hinamiku415/-2025-C-/04_Docs_Protocols/26年电赛校赛设计文档.docx

# 基于单目视觉的运动目标物测量装置

## 摘要

本系统以树莓派4B为视觉核心、STM32F103VET6单片机为小车控制核心，STM32F103C8T6为测量电路主控。树莓派搭载OpenCV视觉处理框架，采用Picamera2摄像头采集目标板图像，通过OTSU自适应阈值与Canny边缘检测相结合的三路径检测算法实现A4目标板外框检测，使用透视变换将图像矫正到标准坐标系，利用单目焦距公式实现0~200cm范围内非接触测距，同时实现圆形、三角形、正方形的形状识别与边长测量。小车上搭载A4纸大小目标物固定板，通过蓝牙JDY-31无线通信接收树莓派下发的定距指令，采用编码器电机配合位置式串联PID闭环控制实现轴线精准循迹、定距行进与自动停止。测量电路采用INA226高精度电流传感器与5mΩ采样电阻实现系统供电电流Is和功率P的实时监测，对最大功率Pmax进行追踪。测量电路与树莓派之间通过UART串口进行状态切换与数据交互，HMI串口屏负责用户交互与结果显示。实验结果表明，系统可在规定时间内完成全部测量与控制任务，距离测量误差小于2.0cm、尺寸测量误差小于0.3cm，小车行驶距离误差小于0.5cm，电流误差满足竞赛指标要求，系统运行稳定、响应迅速。

关键词： 树莓派4B、STM32F103、单目视觉、PID算法、蓝牙通信、INA226、OpenCV

## 1. 方案论证

### 1.1 方案分析与选择

1.1.1 视觉处理方案选择

方案一：采用K210/Kendryte AI芯片内置卷积加速器进行边缘检测与图像处理。优点是内置硬件加速、功耗低；缺点是算力有限，复杂视觉算法(如多路径框检测、YOLO推理)难以运行，开发灵活性不足。

方案二：采用OpenMV Cam嵌入式视觉模块。优点是开发简便、内置常用视觉算法；缺点是分辨率受限、处理帧率低，透视变换和多帧融合等复杂操作性能不足。

方案三：采用树莓派4B + Picamera2 + OpenCV方案。优点包括：4核ARM Cortex-A72处理器算力充沛，可在1280x720分辨率下实现60fps画面采集与实时处理；OpenCV库提供完整的二值化、形态学操作、轮廓检测等算法支持；支持MJPG Web视频流远程监控调试；可运行ONNX Runtime进行YOLOv5推理实现数字识别；具备蓝牙RFCOMM Socket直接控制小车。缺点是功耗稍高(约5V/2A)。综合考虑竞赛对精度、速度和多模式测量的要求，选择方案三。

1.1.2 小车通信方案选择

方案一：NRF24L01 2.4GHz无线模块通过SPI与STM32通信。优点是低延迟、可配置性强；实测存在SPI通信易受电机振动和电源噪声干扰、芯片频繁进入掉电模式、半双工限制下持续发送接收不稳定等严重问题。

方案二：蓝牙JDY-31模块通过UART与STM32通信。优点是抗干扰能力强、全双工通信、协议简单可靠(文本指令GO/STOP/TARGET)、树莓派内置蓝牙无需额外硬件。缺点是延迟略高于NRF24L01(约20ms)。经过实际测试对比，蓝牙方案稳定性远超NRF24L01，停车精度满足竞赛要求，选择方案二。

1.1.3 测量电路方案选择

方案一：采用ADC直接采样精密电阻两端电压，由STM32内置12位ADC转换计算电流。优点是电路简单、成本低；缺点是分辨率有限(5V/4096=1.22mV/LSB)，小电流下读数噪声大，功率计算精度差。

方案二：采用INA226专用电流/功率监测芯片。优点是集成16位ADC，内置分流电压测量(2.5μV/LSB)、总线电压测量(1.25mV/LSB)、功率计算和校准寄存器；通过I2C接口直接读取工程值，精度高、抗干扰强。选择方案二。

1.1.4 主控芯片选择

测量电路主控选用STM32F103C8T6，小车端主控选用STM32F103VET6。C8T6负责串口屏交互、树莓派通信、OLED显示、按键响应和INA226电流监测；VET6负责电机PWM驱动、编码器PID控制、循迹传感器采集和蓝牙指令接收。

### 1.2 方案描述

系统整体架构采用”一树莓派 + 双STM32”三核心分布式结构，如图1所示。

树莓派4B视觉子系统： 运行Python视觉处理程序(main.py)，负责Picamera2摄像头采集(1280x720@60fps)、A4目标板外框检测(三路径互补算法)、距离测量(焦距公式)、形状识别与尺寸测量(模式2~5)、数字识别(模板匹配/YOLOv5 ONNX)。通过USB转TTL模块(UART，115200bps)与测量电路STM32通信，通过内置蓝牙(JDY-31 RFCOMM)与小车通信。

测量电路STM32F103C8T6： 负责系统主控逻辑。通过HMI串口屏(USART1，9600bps)接收用户模式选择和参数输入(D/N)；通过UART串口(USART3，115200bps)与树莓派交互控制指令和测量数据；通过I2C接口读取INA226电流传感器数据，计算Pmax并刷新HMI显示；通过OLED 12864显示系统状态。按键1(PA8)实现一键启动全自动操作。

小车端STM32F103VET6： 负责运动执行。通过UART4(9600bps)接收蓝牙GO/STOP指令；TIM1 10ms中断驱动位置式串联PID(位置环+速度环+转向环)控制双电机；编码器(MG513X，1456线四倍频)反馈里程；八路灰度循迹模块通过权重法(-7~+7)实现轴线循迹。

完整工作流程： 用户在HMI屏选择竞赛题目对应状态并输入参数，按下物理按键一键启动 → STM32通过串口发送MODE指令给树莓派 → 树莓派切入实时测距模式，通过蓝牙发送GO启动小车 → 树莓派60fps持续测距并通过串口发送D值给STM32显示 → 当距离达到目标值+提前量(15cm)时发送蓝牙STOP → 小车反向制动停车 → 树莓派检测停稳后自动切到目标测量模式拍照测量 → 结果通过串口回传STM32 → HMI屏和OLED显示测量结果，同时显示电流和功耗数据。

## 2. 理论分析与计算

### 2.1 单目视觉测量分析

2.1.1 测距原理

本系统采用基于已知目标物尺寸的单目测距方法。摄像头固定在支架上，对前方A4标准目标板（黑框白底，外框21.0cm×29.7cm）进行拍摄。根据小孔成像模型，目标物在图像中的像素高度h_px与实际距离D满足反比关系：

D=(F×H)/(h_(px))

其中F为相机焦距像素值，H为A4纸高度29.7cm。焦距F通过标定获得：将目标板放置在已知距离D_cal处，测量其在图像中的像素高度h_cal，计算F = D_cal × h_cal / H。本系统标定焦距F=1697.80。

为提高测量稳定性，取A4纸左右两侧高度像素的最大值作为h_px，并通过15帧中值滤波消除瞬时噪声。

2.1.2 外框检测算法

系统采用三条互补检测路径实现不同光照条件下的鲁棒框检测：

- 路径A（OTSU二值化）： 对高斯模糊后的灰度图进行OTSU自适应阈值二值化，使用15/30/50/80四种核大小的形态学闭运算连接白色区域，提取轮廓并通过approxPolyDP四边形逼近和宽高比验证筛选候选。
- 路径B（自适应阈值）： 采用高斯自适应阈值(blockSize=51, C=10)处理非均匀光照场景(阴影、亮斑)，形态学处理后检测轮廓。
- 路径C（Canny边缘检测）： 对低对比度场景使用Canny边缘检测(阈值30/120)提取边缘轮廓，不依赖二值化结果。

三条路径的所有候选合并去重(中心距<30px)，最终选取面积最大的四边形作为A4目标板外框。

2.1.3 透视变换与尺寸测量

检测到目标板四角点后，通过透视变换将目标板映射到630×891像素的标准矩形坐标系(PX_PER_CM=30)。在矫正后的正视图上进行图形检测和尺寸测量，边长x_cm = 边长像素 / px_per_cm，其中px_per_cm取水平和垂直缩放系数的平均值。

2.1.4 图形识别原理

模式2（形状识别）： 对矫正图像进行OTSU反向二值化提取黑色图形，排除黑框区域后检测轮廓。通过approxPolyDP顶点数判断形状(3个顶点=三角形，4个顶点=正方形，>8个顶点=圆形)。正方形通过边长比(max/min≤1.20)和内角偏差(≤22°)验证。

模式3（多正方形最小边长）： 检测所有黑色正方形，通过相邻直角点对法和轮廓兜底法双重检测，IoU去重后输出最小边长。

模式4/5（带编号正方形+倾斜矫正）： 对每个检测到的正方形内区域，通过模板匹配或YOLOv5 ONNX推理识别数字编号。模式5下TiltCorrector类估算倾斜角度(利用对边比arccos)并施加二次透视变换补偿前缩效应。

### 2.2 小车行驶分析

在本任务中，小车行驶核心任务是完成轴线循迹、定距行进、精准停驻，满足竞赛对行驶偏差、距离误差、自动控制的硬性要求，全程由测量电路通过蓝牙无线通信下发指令，无人工干预与遥控操作。

2.2.1 小车控制分析

本系统小车采用TB6612电机驱动、MG513X编码器直流电机，通过定时器通道输出PWM信号控制小车行进速度，以循迹模组获取轴线偏差数据，编码器实时反馈行驶里程，通过蓝牙JDY-31无线模块接收行进距离，由位置式串联PID闭环算法：

u(k)=K_p e(k)+K_i ∑_(j=0)^k e(j)+K_d [e(k)-e(k-1)]

控制电机转速、转向与位置。系统采用三层串联PID结构： - 位置环（外环）： 以目标距离TotalError为输入，编码器累计距离Actual_Location为反馈，输出目标速度给速度环 - 速度环（内环）： 以位置环输出为设定速度，10ms编码器增量/周期为实际速度反馈，输出PWM占空比 - 转向环（差速控制）： 以循迹模块输出的轴线偏差值(-16~+16)为输入，对左右电机施加差速分量

2.2.2 轴线循迹分析

本系统小车轴线循迹采用八路灰度循迹模块，循迹模块通过串行输出，将灰度传感值返回数字量并在程序上移位获取八位二进制数。为使小车能够精准沿着轴线行进，使用权重法，将循迹二进制数各个位数赋予权重[-7, -5, -3, -1, 1, 3, 5, 7]并相加转化为十进制数作为转向环PID的输入，由此得出循迹的输入量范围为-16~16。通过配置PWM通道的计数周期和预分频值确定目标范围在-7200~7200，通过计算峰值处于输入范围7200/32，确定比例项的范围在225左右，通过Vofa串口波形图显示软件，结合经验参数以此确定比例、积分、微分的参数数值。

2.2.3 定距行进与停驻控制分析

本系统小车采用位置式串联PID，通过位置环作为外环、速度环作为内环、转向环作为差速控制来控制整个小车的运动控制。轮子采用橡胶轮直径为65mm，电机采用MG513X，减速比为1:28，13线，一圈脉冲为13×28=364，四倍频脉冲为1456，圆周率取3.14，由此得出小车每脉冲行进距离公式为：

S_单脉冲 = 轮子周长/四倍频脉冲数 = 6.5cm × 3.14 / 1456 = 0.014017 cm

通过获取编码器数值，得出小车实际行进总距离公式为：

S_总 = (左轮脉冲数 + 右轮脉冲数) / 2 × S_单脉冲

以S_总作为位置环PID的输入，此外每10ms获取一次编码器的累计值相加求平均作为速度环的实际速度，以位置环的输出作为速度环的输入，实现高抗干扰和高精确度。

2.2.4 蓝牙停车策略

树莓派以60fps频率持续测距，当实时稳定距离stable_d ≤ 目标距离target_d + 提前量(15cm)时，通过蓝牙发送STOP指令给小车。小车收到STOP后执行反向制动(PWM=-800, 持续200ms)后PWM置零停车。树莓派继续测距，连续5帧距离变化<0.5cm确认停稳后，切换到目标测量模式执行视觉测量。这一策略补偿了蓝牙指令传输延迟(~20ms)和刹车惯性距离，确保实际停车位置与目标距离的偏差在容许范围内。

### 2.3 测量电路分析

2.3.1 电流/功率检测原理

采用INA226AQDGSRQ1专用电流/功率监测芯片，配合R8采样电阻（标称5mΩ）实现供电电流和功率的实时测量。

配置参数： - 校准值计算：Calib = 0.00512 / (Current_LSB × R_shunt)，其中Current_LSB = I_MAX / 32768 - 最大测量电流I_MAX设置为1.1A，R_shunt标称值为0.005Ω，Calib计算值约3052 - 转换配置：平均16次采样，转换时间1.1ms，连续测量分流电压和总线电压

两条电流计算路径： - 路径A（芯片内部计算）： I = 电流寄存器值 × Current_LSB，依赖校准寄存器写入正确 - 路径B（Raw软件计算）： I = 分流电压(μV) / R_shunt(Ω) / 1000 × RAW_CORRECTION，不依赖校准值

实测采样电阻实际阻值约2.4mΩ（与标称值有偏差，PCB并联路径导致），通过RAW_CORRECTION=2.08补偿Raw路径，通过调整I_MAX使I路径读数校正。

功率计算： - P_实时(mW) = 总线电压寄存器值 × 1.25mV/LSB × I(mA) - P_max = max(P_实时) ——在每次采样时追踪最大值

2.3.2 系统功耗分析

系统供电电压标称5V，树莓派4B满负荷功耗约5V/2A=10W，STM32+外围设备功耗约5V/0.2A=1W，驱动板+电机功耗随负载变化约5V/0.5~2A。系统总峰值功耗约10W+1W+10W≈21W。测量电路通过INA226以约200ms周期持续采样电流和功率，向HMI屏发送t_Is(电流mA)、t_P(功率mW)、t_Pm(最大功率mW)显示。

### 2.4 误差分析

2.4.1 单目视觉误差分析

1. 焦距标定误差： 焦距标定时人工测量距离存在±0.5cm测量误差，经传播后对测量结果的影响为δD = (D / D_cal) × δD_cal，当标定距离80cm时，80cm处误差约±0.5cm，200cm处误差约±1.25cm
2. 像素量化误差： 摄像头分辨率为1280×720，在200cm处A4纸高度约85像素，每像素对应约200×29.7/85×85×85/1697.8≈2.3cm/像素的测距分辨率，通过中值滤波和多帧均值有效降低
3. 外框检测漂移： 光照变化或遮挡导致角点定位偏差，通过8帧滑动窗口平滑(连续50帧丢失则使用最后有效值)保证稳定性
4. 透视变换累积误差： 角点偏差通过透视变换传递到尺寸测量，多帧(5帧)中位数聚合策略抑制单帧异常
5. 倾斜测量误差(模式5)： TiltCorrector利用对边比arccos估算倾斜角，理想条件下cos(30°)=0.866，cos(60°)=0.5，角度估计误差容差为5°

2.4.2 小车行进误差分析

1. PID参数导致的过冲振荡导致偏离指定位置：位置环Kp过大引起编码器目标距离处的过冲，Kd可抑制振荡但过大引入噪声
2. 电机参数与商家标定有出入：实测MG513X电机减速比和脉冲数与标称值存在微小偏差，导致编码器计算距离与实际距离略有差距，需通过实测标定修正S_单脉冲值
3. 轮胎打滑：橡胶轮与地面摩擦力不足时编码器计数而轮胎未实际滚动，尤其在急加速/减速时显著
4. 循迹偏差：八路灰度模块在光照变化或地板颜色不均时可能误判轴线位置，导致小车偏离预设轨迹

2.4.3 测量电路误差分析

1. 采样电阻精度： R8标称5mΩ±1%，实际阻值因PCB并联路径降至约2.4mΩ，通过RAW_CORRECTION=2.08校正后残余误差约±3mA
2. INA226 ADC精度： 分流电压分辨率2.5μV/LSB，对应R=5mΩ时电流分辨率0.5mA/LSB，16次平均后噪声降低至±1mA
3. 总线电压测量误差： 分辨率1.25mV/LSB，5V满量程误差约0.025%，工程上可忽略
4. 温度漂移： 采样电阻温漂系数约±50ppm/°C，工作温度变化20°C引入约0.1%误差，对竞赛场景影响微小

## 3. 电路与程序设计

### 3.1 单目视觉设计

3.1.1 软件架构

树莓派视觉系统采用Python编写，核心文件及功能如下：

文件 | 功能
main.py | 主程序入口：摄像头采集、Flask Web服务(可选)、后台帧处理线程、串口监听、蓝牙小车控制逻辑
config.py | 全局参数：串口/蓝牙/相机配置、物理尺寸、检测阈值、数字识别方式
modes.py | 测量核心：模式1~5实现，含透视变换、正方形检测、形状分类、倾斜矫正、多帧融合
utils.py | 视觉工具：三路径外框检测、测距公式(焦距模型)、焦距标定、距离缓冲区
serial_comm.py | 串口通信：与STM32的UART通信，支持二进制帧和文本行协议
bt_comm.py | 蓝牙通信：JDY-31 RFCOMM Socket，GO/STOP/TARGET指令，断线自动重连
templates.py | 模板匹配数字识别：多变体模板加载、比值测试+绝对距离双重判别
yolo_num.py | YOLOv5 ONNX数字识别（可选）：ONNX Runtime推理、3检测头anchor解码、NMS后处理

3.1.2 视觉处理流水线

1. 帧采集： Picamera2 1280×720 RGB @ 60fps
2. 外框检测(utils.py detece_a4_outer)： 三路径互补 → 候选合并去重 → 选最大面积
3. 时间平滑(main.py get_stable_outer)： 8帧滑动窗口角点均值
4. 模式路由(mode 0~5)：
  - 模式1：实时测距+中值滤波，持续输出D值
  - 模式2：透视变换+轮廓形状辨识
  - 模式3：正方形检测+最小边长
  - 模式4：正方形+模板匹配/YOLO数字编号
  - 模式5：倾斜角估计+二次透视矫正+编号方形
5. 多帧融合： 拍5帧(间隔50ms)，距离和边长取中位数，模式4/5按编号聚合
6. 结果输出： 通过串口发送D:值,shape:类型,x:尺寸或D:值,N:编号,x:尺寸给STM32

3.1.3 关键算法参数

参数 | 值 | 说明
焦距 | 1697.80 px | 标定值
A4黑框尺寸 | 21.0×29.7 cm | W×H，实测值
透视变换像素 | 30 px/cm | PX_PER_CM
框检测最小面积 | 画面2% | 排除噪点
宽高比容差 | ±20% | 排除正方形等干扰
平滑窗口 | 8帧 | 时间稳定性
正方形验证 | 边长比≤1.20, 角度偏差≤22° | 质量控制
多帧数 | 5帧, 间隔50ms | 抗波动
模板对比值阈值 | 0.75 | 最佳/次佳比
倾斜角范围 | 30°~60° | 模式5

### 3.2 小车程序设计

设计思路为：系统小车开启后，设定小车标志位和状态机，当测量电路蓝牙无线通信模块JDY-31发送启动指令GO后，行进标志Car_state2置1，此时启动小车以PID目标速度7匀速前进并开启循迹。当到达指定距离后，树莓派通过视觉测距判断距离达标，蓝牙发送STOP指令，小车收到后反向制动200ms后停车，PWM通道置0，蜂鸣器发出声光提示1秒。

小车状态机： - Car_state2=0：静止(idle) - Car_state2=1：蓝牙收到GO后启动，匀速前进+循迹 - Car_state2=2：到达目标，蜂鸣响1秒后自动切回0

定时中断(TIM1 10ms)： - Key_Tick()：按键消抖 - Control_kick()：到达检测(Car_state模式) - Encoder_Read()：编码器脉冲读取累加 - Read_Track_DATA()：八路灰度采集 - Track_Control()：循迹转向控制 - Target_Location_arrive_D()：蓝牙模式下PID速度控制(target=7) - Target_Location_arrive()：基础1编码器PID位置控制

### 3.3 测量电路设计

3.3.1 STM32F103C8T6主控设计

测量电路以STM32F103C8T6为控制核心，主要功能模块：

串口及通信： - USART1(PA9/PA10, 9600bps)：连接淘晶驰TJC HMI串口屏，单向接收状态切换字节(0x00~0x14)，接收文本参数指令(D=xxx/N=x)，向HMI发送Nextion格式显示更新 - USART3(PB10/PB11, 115200bps)：连接树莓派USB转TTL模块，发送MODE:x/TRIGGER/D=xxx/N=x等控制指令，接收D:xxx/形状/尺寸测量结果

I2C外设(PB6/PB7，软件I2C)： - INA226(地址0x40)：电流/电压/功率传感器，200ms周期采样 - OLED 12864(地址0x78)：4行×16字符状态信息显示

GPIO： - PA8：物理按键1(一键启动)，上拉输入，低电平触发

系统状态机(7个状态)： - STATE_IDLE(0)：空闲 - STATE_BASIC_1(1)：基础1-小车循迹1米 - STATE_BASIC_2(2)：基础2-静止测量 - STATE_BASIC_34(3)：基础3/4-前进到D停止测量 - STATE_ADV_1(4)：发挥1-静止测最小正方形 - STATE_ADV_2(5)：发挥2-前进测最小正方形 - STATE_ADV_3(6)：发挥3-前进测指定编号正方形 - STATE_ADV_45(7)：发挥4/5-倾斜板前进测量

一键启动逻辑： 用户通过HMI屏选择状态并输入参数后，按物理按键一键启动。App_HandleKey()根据当前状态发送对应的MODE、D、N指令给树莓派，树莓派根据指令自动完成小车启动、停车监控、视觉测量、结果回传整个流程，无需二次人工干预。

HMI通信协议： - HMI→STM32： - 状态切换：单字节(0x00=IDLE, 0x01~0x14=各状态) - 参数指令：文本行(D=xxx\n, N=x\n)，Command_Parser()解析 - STM32→HMI： - 控件更新：obj.txt=“value” + 0xFF 0xFF 0xFF(Nextion格式) - 主要控件：D(距离cm)、X(边长cm)、N(编号列表)、t_Is(电流mA)、t_P(功率mW)、t_Pm(最大功率mW)

树莓派通信协议(文本行，\n结尾)： - STM32→树莓派：MODE:2/3/4/5、TRIGGER、D=150、N=2 - 树莓派→STM32：D:120.50、D:120.50,shape:square,x:8.30、D:80.42,N:4,x:9.67、STATUS:mode=3,status=2、ERROR:xxx

## 4. 测试方案与测试结果

### 4.1 测试方案

4.1.1 测试环境与仪器

- 测量距离：卷尺(精度1mm)，用于验证视觉测距结果
- 尺寸测量：游标卡尺(精度0.02mm)，用于验证图形边长测量结果
- 电流监测：数控直流稳压电源(带电流显示，精度1mA)，用于验证INA226电流读数
- 小车距离：地面标记+卷尺，用于验证小车行驶距离精度
- 测试场景：室内均匀光照环境，目标板垂直放置于平整地面

4.1.2 测试项目

基础部分测试： 1. 基础1：小车循迹1米行驶距离测试——测量小车实际行驶距离与目标距离(100cm)的偏差 2. 基础2：静止测量测试——目标板固定在不同距离(80~200cm)处，测量距离D的准确性及形状识别的正确率 3. 基础3：前进到D1距离停止后测量——验证小车自动停止位置的精度及随后的视觉测量准确度 4. 基础4：前进到D2距离停止后测量——测试不同目标距离下的全自动流程

发挥部分测试： 5. 发挥1：静止状态下检测多个正方形的最小边长——验证重叠正方形检测和最小边长识别能力 6. 发挥2：前进到D3距离停止后检测最小正方形——验证运动+测量全流程 7. 发挥3：前进到D4距离停止后检测指定编号正方形的边长——验证编号识别准确率 8. 发挥4/5：目标板倾斜30°~60°时识别指定编号正方形——验证倾斜矫正算法的准确性 9. 发挥6：系统供电电流Is和功率P/Pmax实时监测——验证INA226电流监测精度

4.1.3 测试方法

通过测量电路的蓝牙无线通信模块向小车发送指定距离行进指令，小车自动前进并停驻。树莓派执行单目视觉测量获得边长与距离数据。同时测量电路监测电流和功率大小。将各项测量数据与真值对比，验证是否满足竞赛任务要求。

### 4.2 测试结果

4.2.1 基础部分

距离测量精度测试：

实际距离 (cm) | 测量距离 (cm) | 误差 (cm) | 误差率
80 | 79.8 | -0.2 | 0.25%
100 | 100.5 | +0.5 | 0.50%
120 | 119.7 | -0.3 | 0.25%
150 | 150.8 | +0.8 | 0.53%
180 | 178.5 | -1.5 | 0.83%
200 | 201.2 | +1.2 | 0.60%

最大误差1.5cm，满足竞赛≤2.0cm的指标要求。

形状尺寸测量精度测试(距离120cm处)：

图形类型 | 实际尺寸 (cm) | 测量尺寸 (cm) | 误差 (cm)
圆形(直径) | 8.0 | 8.15 | +0.15
三角形(边长) | 8.0 | 7.92 | -0.08
正方形(边长) | 8.0 | 7.85 | -0.15

最大误差0.15cm，满足竞赛≤0.3cm的指标要求。

小车行驶距离测试(目标100cm)：

测试次数 | 实际行驶距离 (cm) | 误差 (cm)
1 | 100.3 | +0.3
2 | 99.5 | -0.5
3 | 100.1 | +0.1

最大误差0.5cm，满足竞赛≤0.5cm的指标要求。

小车自动停车精度测试(蓝牙方案，目标150cm)：

测试次数 | 实际停车距离 (cm) | 误差 (cm)
1 | 149.5 | -0.5
2 | 150.3 | +0.3
3 | 148.8 | -1.2

最大误差1.2cm，在竞赛容许范围内。

形状识别正确率：

图形类型 | 测试次数 | 正确次数 | 正确率
圆形 | 20 | 20 | 100%
三角形 | 20 | 20 | 100%
正方形 | 20 | 20 | 100%

4.2.2 发挥部分

多正方形最小边长(x)检测测试：

正方形数量 | 最小边长真值 (cm) | 测量最小边长 (cm) | 误差 (cm)
3个(含重叠) | 4.0 | 4.12 | +0.12
3个(含重叠) | 5.0 | 4.88 | -0.12

编号识别准确率测试：

编号 | 测试次数 | 正确次数 | 正确率
1 | 20 | 20 | 100%
2 | 20 | 20 | 100%
3 | 20 | 19 | 95%
5 | 20 | 20 | 100%
8 | 20 | 18 | 90%

模板匹配总体正确率约97%。编号8误识别主要源于与数字0的形似。

倾斜矫正(模式5)指定编号正方形边长测量：

倾斜角 | 编号 | 实际边长 (cm) | 测量边长 (cm) | 误差 (cm)
30° | 2 | 8.0 | 7.82 | -0.18
45° | 2 | 8.0 | 8.22 | +0.22
60° | 4 | 6.0 | 5.76 | -0.24

最大误差0.24cm，满足竞赛≤0.3cm的指标要求。

电流监测精度测试(INA226 vs 数控电源)：

数控电源电流 (mA) | INA226 I路径 (mA) | INA226 Raw路径 (mA) | 误差 (mA)
200 | 199 | 201 | ±2
500 | 498 | 503 | -2/+3
800 | 805 | 802 | +5/+2
1100 | 1108 | 1102 | +8/+2

基于实际采样电阻2.4mΩ与标称值5mΩ的偏差，I路径经MAX_CURRENT_A校正、Raw路径经RAW_CORRECTION=2.08校正后，全范围误差<±10mA，满足竞赛指标。

全流程耗时测试：

流程阶段 | 耗时
HMI选择+按键触发 | <1s
小车从静止到150cm处停稳 | ~4s
停稳检测(5帧确认) | ~0.3s
视觉测量(5帧多帧融合) | ~0.3s
结果发送+HMI显示 | <0.1s
总计 | <6s

满足竞赛10秒内完成全流程操作的要求。

## 5. 总结

本系统通过理论分析得到合理的方案，采用树莓派 + 双STM32三核心架构，实现单目视觉距离和尺寸测量、小车精准循迹定距、自制电流功耗监测三大任务功能。

在视觉测量方面，基于单目焦距模型和三路径互补外框检测算法，实现了0200cm范围内稳定的距离测量(误差<2.0cm)和图形尺寸测量(误差<0.3cm)；通过透视变换+多帧融合策略有效抑制了帧间波动；倾斜矫正器(TiltCorrector)在30°60°倾斜条件下保持了尺寸测量精度。

在小车控制方面，蓝牙JDY-31替代了稳定性不佳的NRF24L01无线模块，配合树莓派60fps实时测距停车监控，实现了精准的自动停车控制；位置式串联PID(位置环+速度环+转向环)结合权重法循迹，保证了轴线行驶精度(偏差<0.5cm)和定距误差(<0.5cm)。

在测量电路方面，INA226高精度电流传感器实现了系统供电电流Is的实时监测和对最大功率Pmax的追踪，两条电流计算路径(芯片I路径和软件Raw路径)互为验证和备份，通过校正系数补偿了采样电阻的阻值偏差。

系统经过全面测试，测量精度、行驶精度、电流误差均满足竞赛指标，6秒内完成全流程操作，运行稳定，各项指标符合”基于单目视觉的运动目标物测量装置”任务要求。
