hinamiku415/-2025-C-/02_Console_STM32/TJC_HMI_Lib/流程图.md

# TJC_HMI_Lib 分层架构流程图

## 架构总览

```mermaid
flowchart TB
    subgraph APP["应用层 (你的代码)"]
        A["用户代码"]
    end

    subgraph CORE["中间层 tjc_hmi.c"]
        direction LR
        C_SEND["SetText() SetNumber() Page()"]
        C_RECV["RxByte() 解析帧 事件回调"]
    end

    subgraph PORT["底层 tjc_hmi_port.c"]
        direction LR
        P_SEND["SendByte() SendBuffer()"]
        P_RECV["USART1_IRQHandler()"]
    end

    subgraph SCREEN["串口屏"]
        direction LR
        S_DISP["显示控件"]
        S_BTN["按钮/输入框"]
    end

    %% 发送流程 - 左侧蓝色
    A -->|"发送指令"| C_SEND
    C_SEND -->|"调用"| P_SEND
    P_SEND -->|"TX 引脚"| S_DISP

    %% 接收流程 - 右侧橙色
    S_BTN -->|"RX 引脚"| P_RECV
    P_RECV -->|"调用"| C_RECV
    C_RECV -->|"事件回调"| A

    %% 样式
    linkStyle 0,1,2 stroke:#1976d2,stroke-width:3px
    linkStyle 3,4,5 stroke:#e65100,stroke-width:3px
```

## 发送流程

```mermaid
sequenceDiagram
    participant App as 应用层
    participant Core as 中间层
    participant Port as 底层
    participant Screen as 串口屏

    App->>Core: TJC_HMI_SetText("D", "120.5cm")
    Core->>Core: 拼接指令 "D.txt=\"120.5cm\""
    Core->>Port: TJC_Port_SendByte('D')
    Core->>Port: TJC_Port_SendByte('.')
    Core->>Port: TJC_Port_SendByte('t')
    Core->>Port: ...
    Core->>Port: TJC_Port_SendByte(0xFF)
    Core->>Port: TJC_Port_SendByte(0xFF)
    Core->>Port: TJC_Port_SendByte(0xFF)
    Port->>Screen: USART_SendData() → TX 引脚
    Screen->>Screen: 显示 "120.5cm"
```

## 接收流程

```mermaid
sequenceDiagram
    participant Screen as 串口屏
    participant Port as 底层
    participant Core as 中间层
    participant App as 应用层

    Screen->>Port: 按钮按下 → RX 引脚
    Port->>Port: USART1_IRQHandler()
    Port->>Port: 读取字节 0xA5
    Port->>Core: TJC_HMI_RxByte(0xA5)
    Core->>Core: 状态机：收到帧头
    Port->>Core: TJC_HMI_RxByte(0x01)
    Core->>Core: 状态机：存入 ID
    Port->>Core: TJC_HMI_RxByte(0x31)
    Core->>Core: 状态机：存入数据
    Port->>Core: TJC_HMI_RxByte(0x5A)
    Core->>Core: 状态机：收到帧尾，解析
    Core->>App: 回调：TJC_EVENT_DATA, id=1, value=1
    App->>App: 判断 ID：1 = 距离
    App->>App: target_D = 1
```

## 两个回调函数

```mermaid
flowchart TD
    subgraph L1["底层"]
        P1["USART1_IRQHandler()"]
    end

    subgraph L2["中间层"]
        C1["TJC_HMI_RxByte()"]
        C2["解析 A5...5A"]
        C3["生成事件"]
    end

    subgraph L3["应用层"]
        A1["HMI_EventHandler()"]
        A2["判断 ID"]
        A3["处理业务"]
    end

    P1 -->|"回调1: 喂字节"| C1
    C1 --> C2
    C2 --> C3
    C3 -->|"回调2: 事件通知"| A1
    A1 --> A2
    A2 --> A3

    style L1 fill:#e8f5e8,stroke:#1b5e20
    style L2 fill:#fff3e0,stroke:#e65100
    style L3 fill:#e1f5fe,stroke:#01579b
```

## 分层职责

| 层 | 文件 | 职责 |
|----|---|---|
| 应用层 | 你的代码 | 定义 ID 含义、处理业务逻辑 |
| 中间层 | tjc_hmi.c | 协议解析、生成事件、控件操作 |
| 底层 | tjc_hmi_port.c | 串口初始化、收发字节、硬件操作 |

## 两个回调函数

| 回调 | 方向 | 作用 |
|---|---|---|
| `TJC_HMI_RxByte()` | 底层 → 中间层 | 喂入接收到的字节 |
| `TJC_HMI_Callback_t` | 中间层 → 应用层 | 通知事件（按钮/数据） |
