hinamiku415/-2025-C-/01_Vision_RaspberryPi/tests/test.jpg

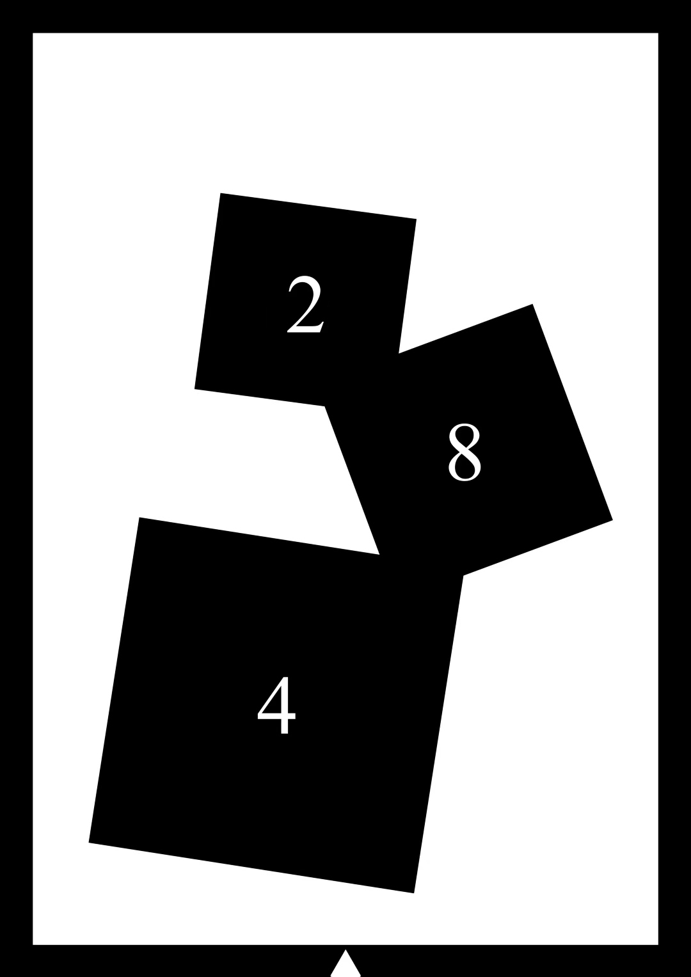
01_Vision_RaspberryPi/tests/test.jpg
