hinamiku415/-2025-C-/assets/demo_result.jpg

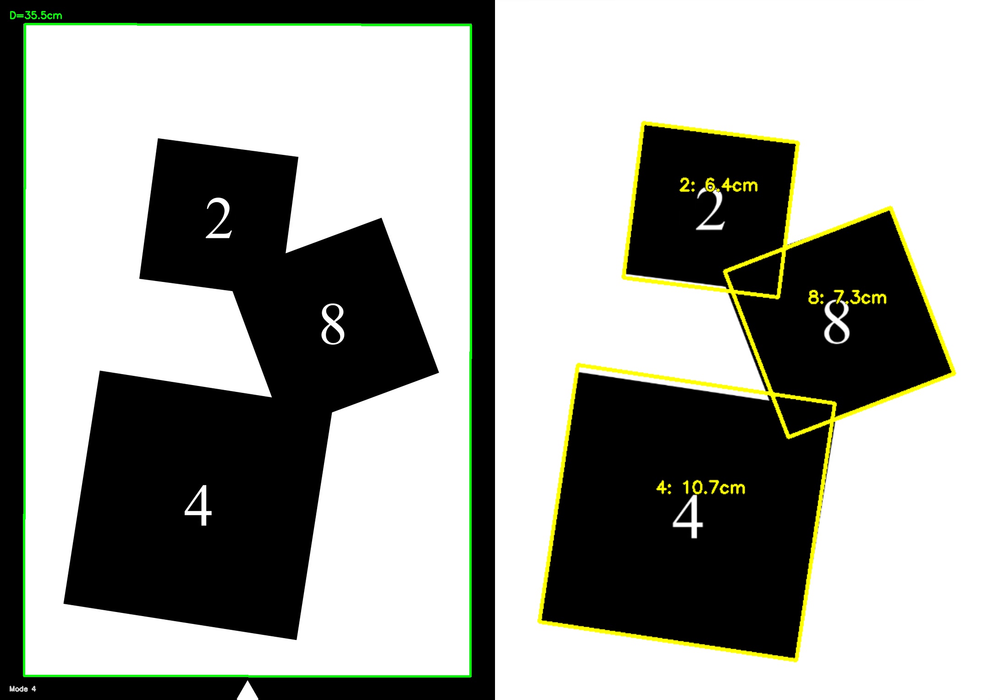
assets/demo_result.jpg
