hinamiku415/-2025-C-/02_Console_STM32/Hardware/Serial.h

#ifndef __SERIAL_H
#define __SERIAL_H

#include <stdio.h>

void Serial_Init(void);
void Serial_SendByte(uint8_t Byte);
void Serial_SendArray(uint8_t *Array, uint16_t Length);
void Serial_SendString(char *String);
void Serial_SendNumber(uint32_t Number, uint8_t Length);
void Serial_Printf(char *format, ...);
void HMI_send_string(char* name, char* showdata);
void HMI_send_number(char* name, int num);
void HMI_send_float(char* name, float fnum);

uint8_t Serial_GetRxFlag(void);
uint8_t Serial_GetRxData(void);

#endif
